CircuitChaos/rgbpi/doc/rgbpi-sch.png

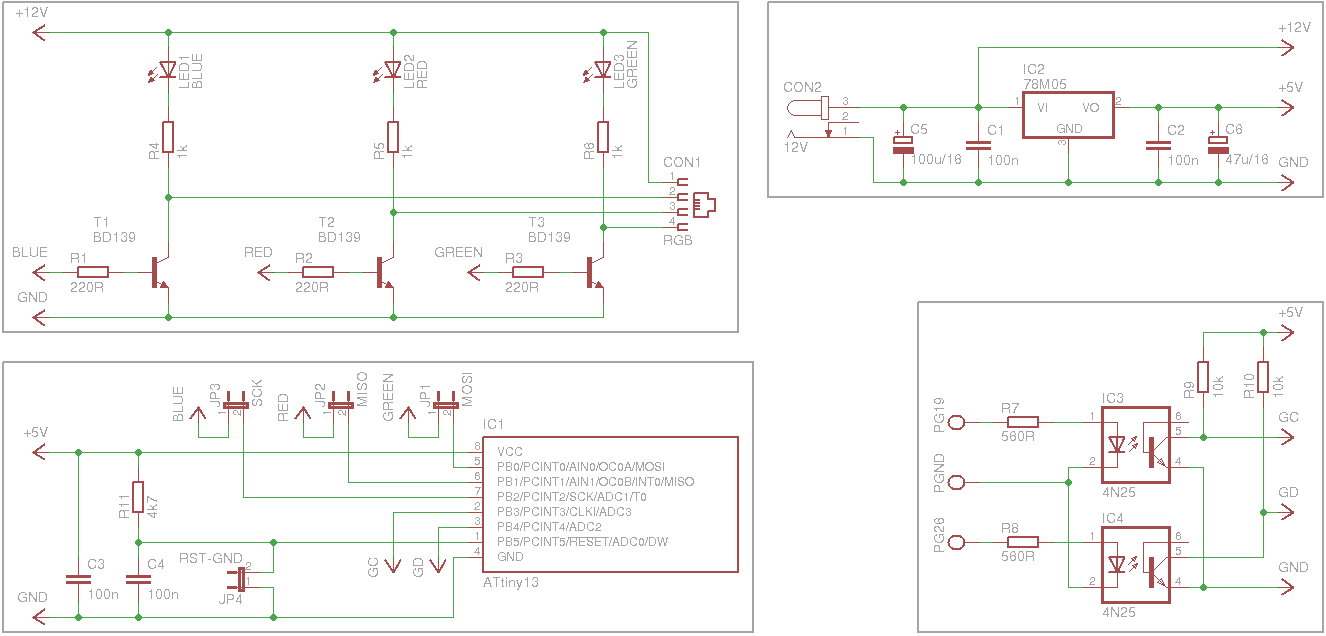
doc/rgbpi-sch.png
