CircuitChaos/rgbpi/doc/rgbpi-pcb.pdf

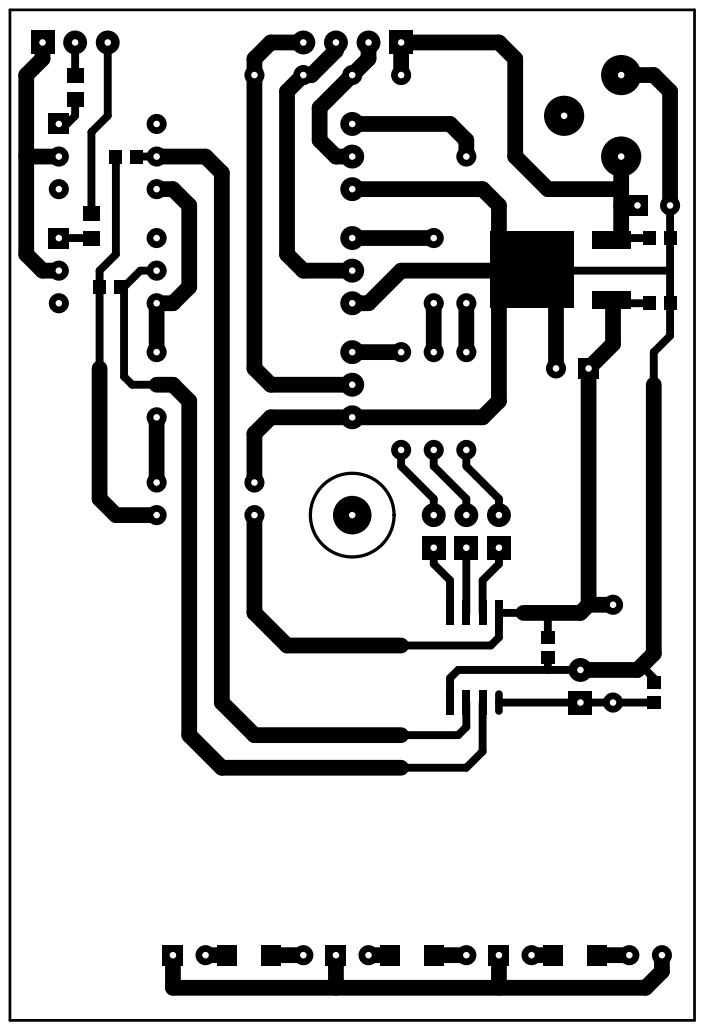
[picture p2: page 1]
