CircuitChaos/rgbpi/(list of files, drawings)

Other design files:
doc/rgbpi-pcb.pcb
