CircuitChaos/rgbpi/doc/rgbpi-sch.sch

## EAGLE design doc/rgbpi-sch.sch (2019-12-28)

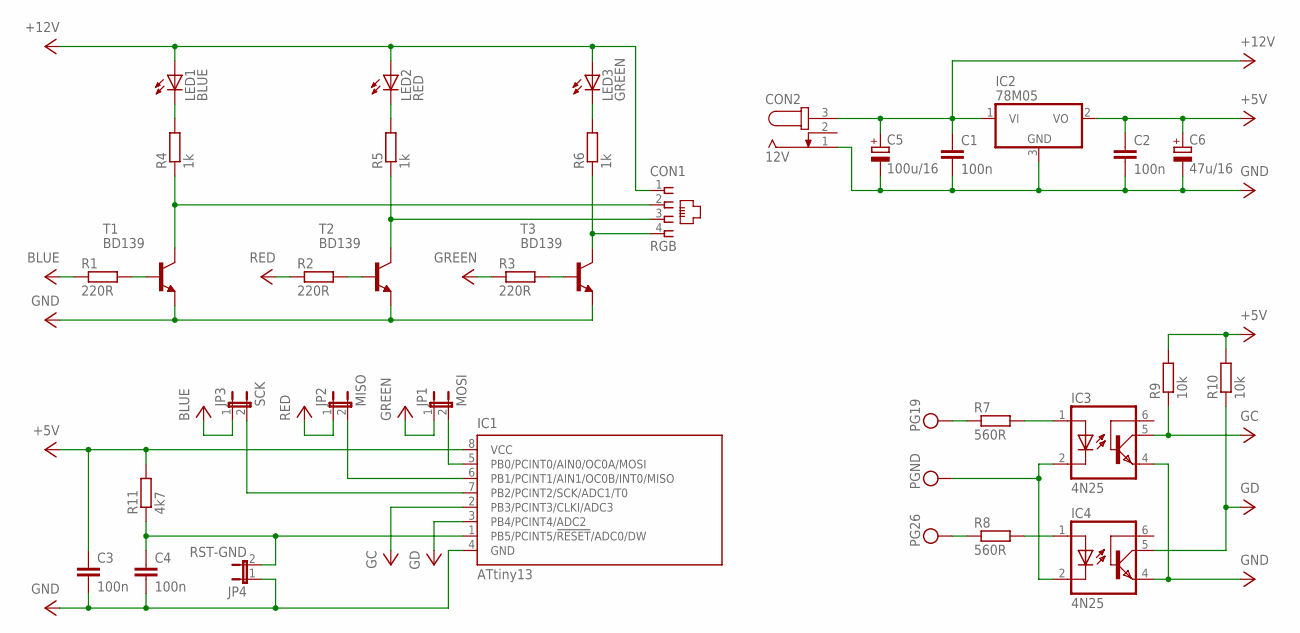
[picture p3: schematic rgbpi-sch.sch]

Parts:
C1, C2, C3, C4: 100n; C2.5-3
C5: 100u/16; 085CS_1AR
C6: 47u/16; 085CS_1AR
CON1: RGB; 215875-3
CON2: 12V; SPC4077
IC1: ATtiny13; 8S1
IC2: 78M05; TO252
IC3, IC4: 4N25; DIL06
JP1: MOSI; JP1
JP2: MISO; JP1
JP3: SCK; JP1
JP4: RST-GND; JP1
LED1: BLUE; W57B
LED2: RED; W57B
LED3: GREEN; W57B
R1, R2, R3: 220R; R0805
R4, R5, R6: 1k; R0805
R7, R8: 560R; R0805
R9, R10: 10k; R0805
R11: 4k7; R0805
T1, T2, T3: BD139; TO126

Connections:
unnamed: R1.2, T1.3 (B)
unnamed: R2.2, T2.3 (B)
unnamed: R3.2, T3.3 (B)
unnamed: IC3.1 (A), R7.2
unnamed: CON1.4, R6.1, T3.2 (C)
unnamed: CON1.3, R5.1, T2.2 (C)
unnamed: CON1.2, R4.1, T1.2 (C)
unnamed: IC4.1 (A), R8.2
unnamed: LED3.C, R6.2
unnamed: LED2.C, R5.2
unnamed: LED1.C, R4.2
unnamed: C4.1, IC1.1 (PB5/PCINT5/!RESET!/ADC0/DW), JP4.2, R11.1
unnamed: IC1.5 (PB0/PCINT0/AIN0/OC0A/MOSI), JP1.2
unnamed: IC1.6 (PB1/PCINT1/AIN1/OC0B/INT0/MISO), JP2.2
unnamed: IC1.7 (PB2/PCINT2/SCK/ADC1/T0), JP3.2
VCC: C1.1, C1.2, C2.1, C2.2, C3.1, C3.2, C4.2, C5.+, C5.-, C6.+, C6.-, CON1.1, CON2.1, CON2.3, IC1.2 (PB3/PCINT3/CLKI/ADC3), IC1.3 (PB4/PCINT4/ADC2), IC1.4 (GND), IC1.8 (VCC), IC2.1 (VI), IC2.2 (VO), IC2.3 (GND), IC3.2 (C), IC3.4 (EMI), IC3.5 (COL), IC4.2 (C), IC4.4 (EMI), IC4.5 (COL), JP1.1, JP2.1, JP3.1, JP4.1, LED1.A, LED2.A, LED3.A, R1.1, R2.1, R3.1, R7.1, R8.1, R9.1, R9.2, R10.1, R10.2, R11.2, T1.1 (E), T2.1 (E), T3.1 (E)
