CircuitChaos/rgbpi/doc/how-to-connect.png

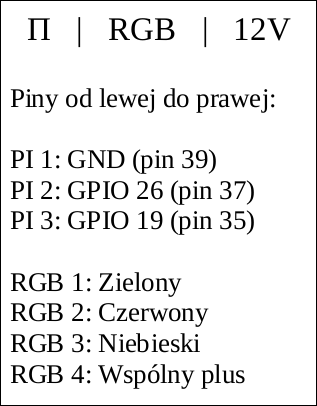
doc/how-to-connect.png
